kasinatorhh/BTSpidey/Design/images/20200213_211251.jpg

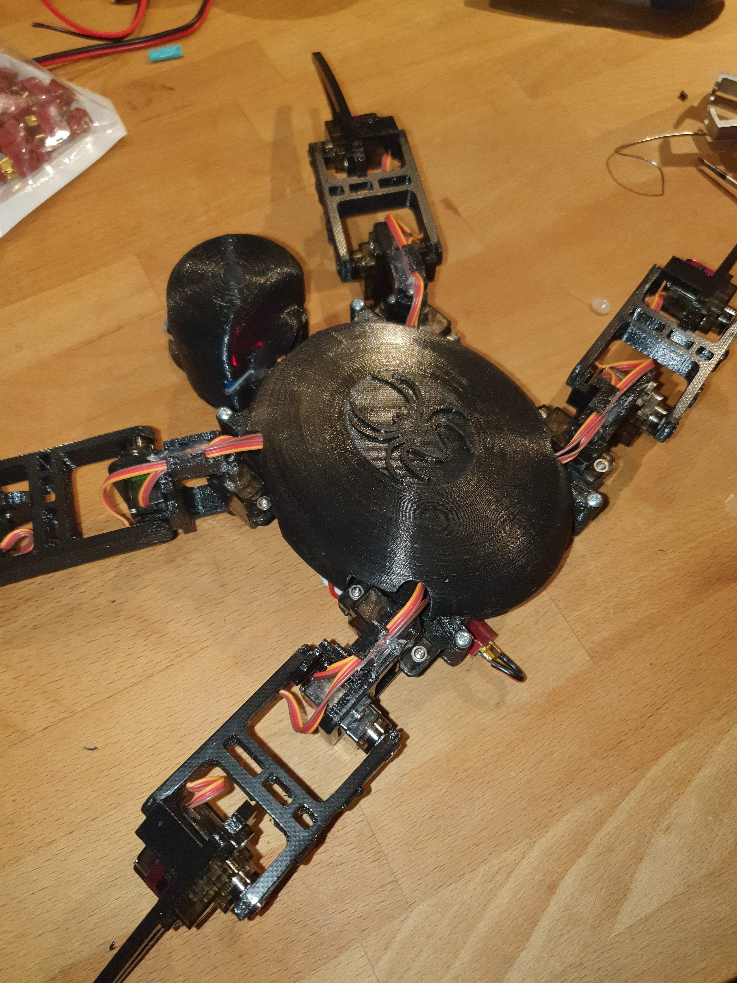
Design/images/20200213_211251.jpg
