kasinatorhh/BTSpidey/Design/images/20200117_162846.jpg

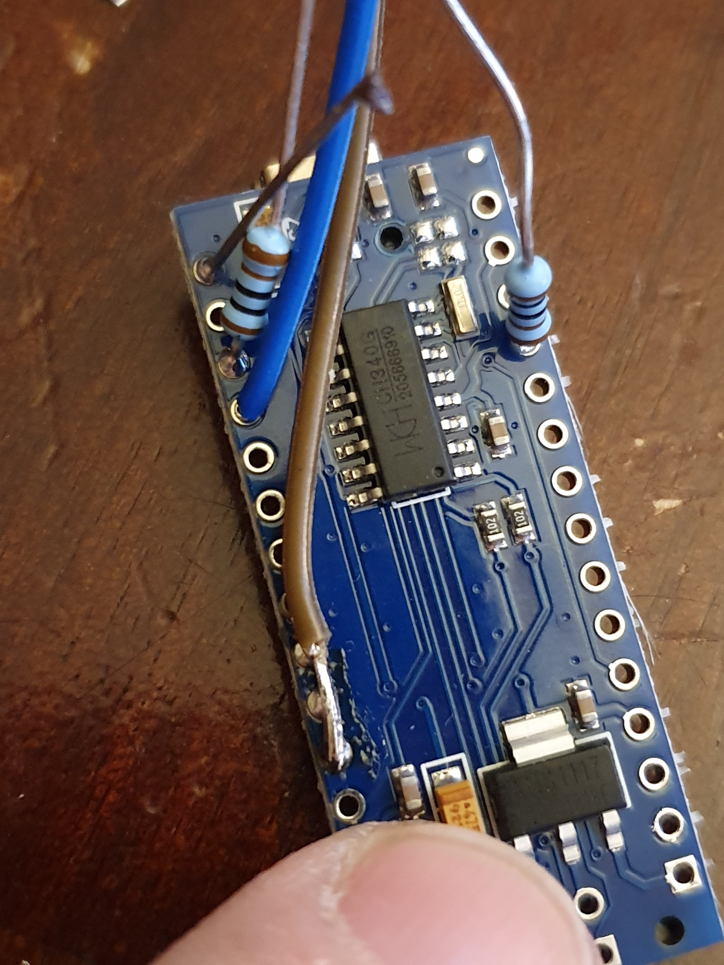
Design/images/20200117_162846.jpg
