kasinatorhh/BTSpidey/Design/README.txt

Spider Bug Robot(quad robot, quadruped)-MG90 by kasinatorhh on Thingiverse: https://www.thingiverse.com/thing:4070234
