kasinatorhh/BTSpidey/Design/images/20191230_092558.jpg

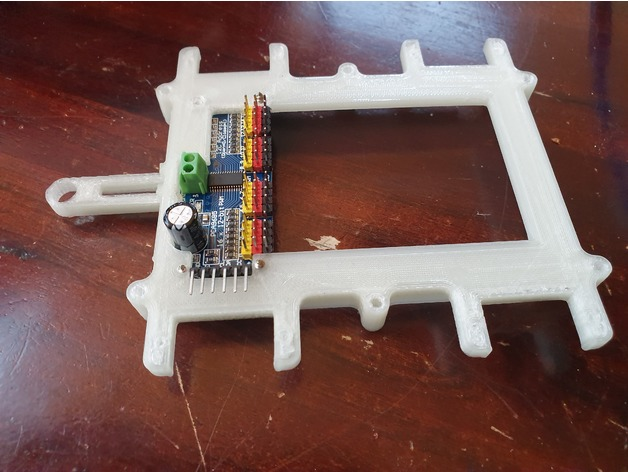
Design/images/20191230_092558.jpg
