kasinatorhh/BTSpidey/Design/images/20200117_161942.jpg

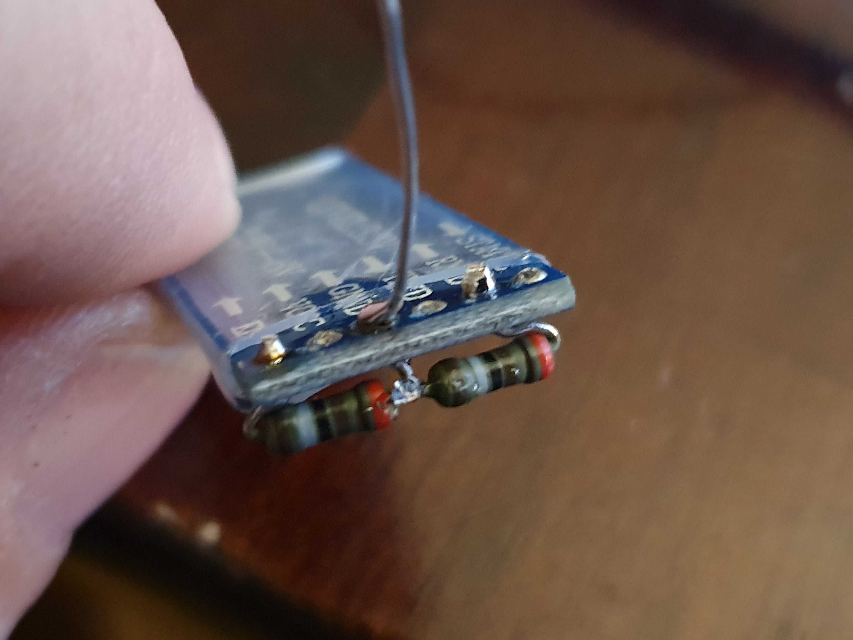
Design/images/20200117_161942.jpg
