kasinatorhh/BTSpidey/Design/images/20200117_161948.jpg

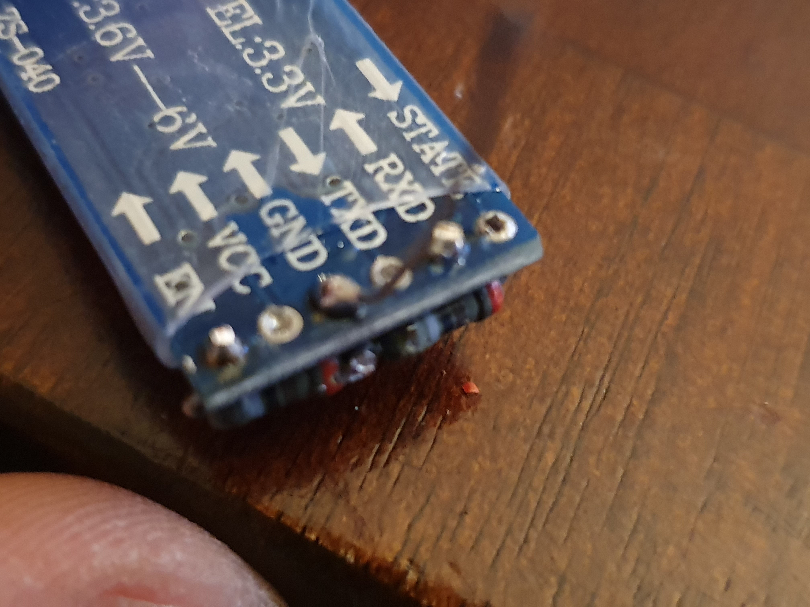
Design/images/20200117_161948.jpg
