kasinatorhh/BTSpidey/Design/images/20200118_225902.jpg

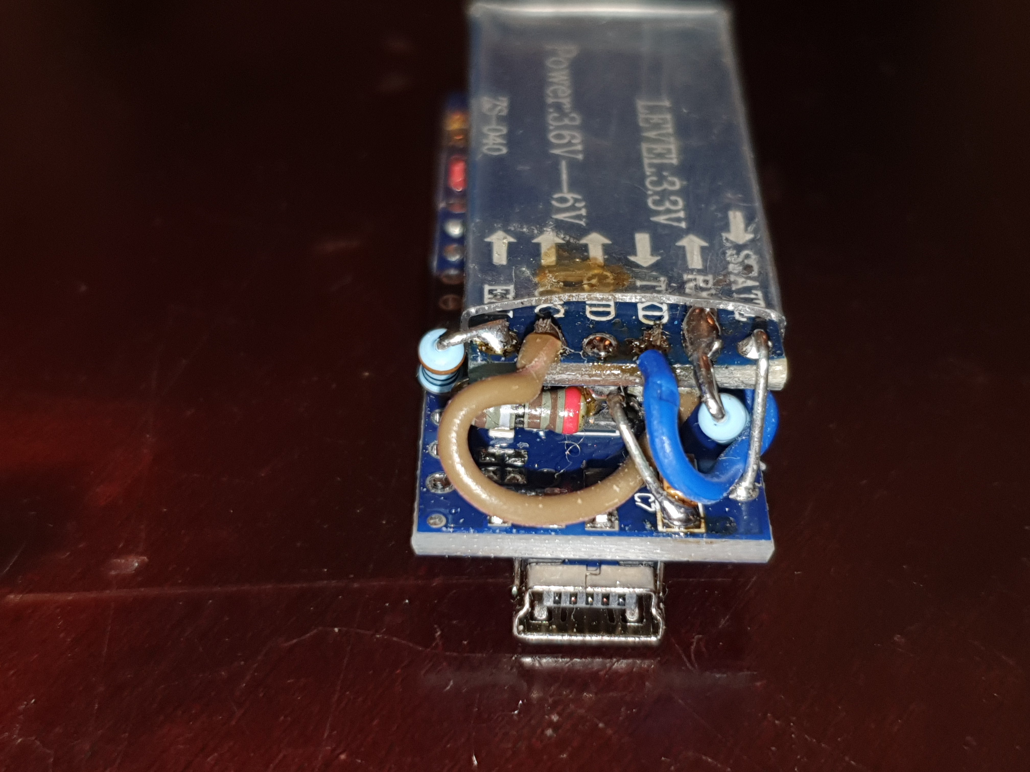
Design/images/20200118_225902.jpg
