kasinatorhh/BTSpidey/Design/images/20200120_192505.jpg

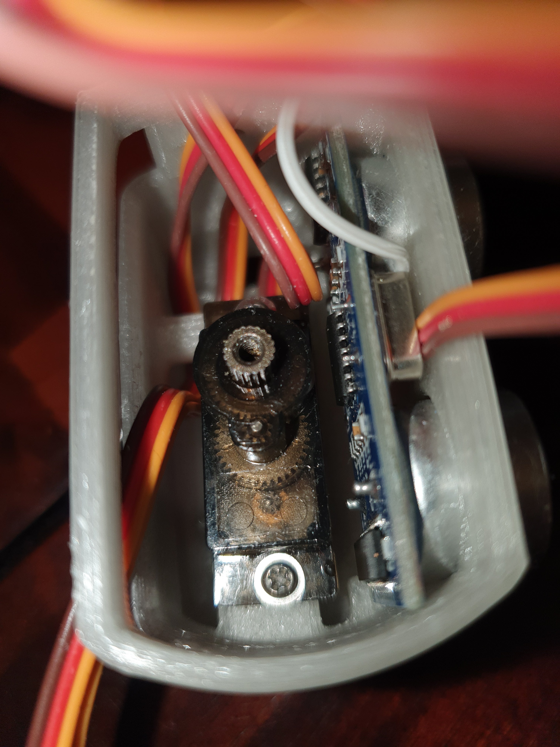
Design/images/20200120_192505.jpg
