kasinatorhh/BTSpidey/Design/images/20200120_193120.jpg

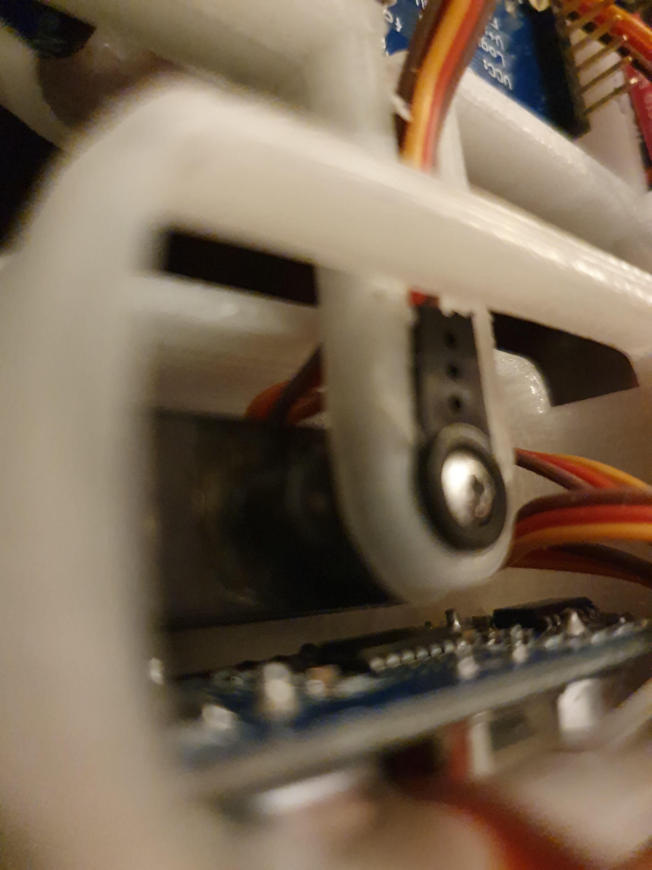
Design/images/20200120_193120.jpg
