kasinatorhh/BTSpidey/Design/images/20200213_205349.jpg

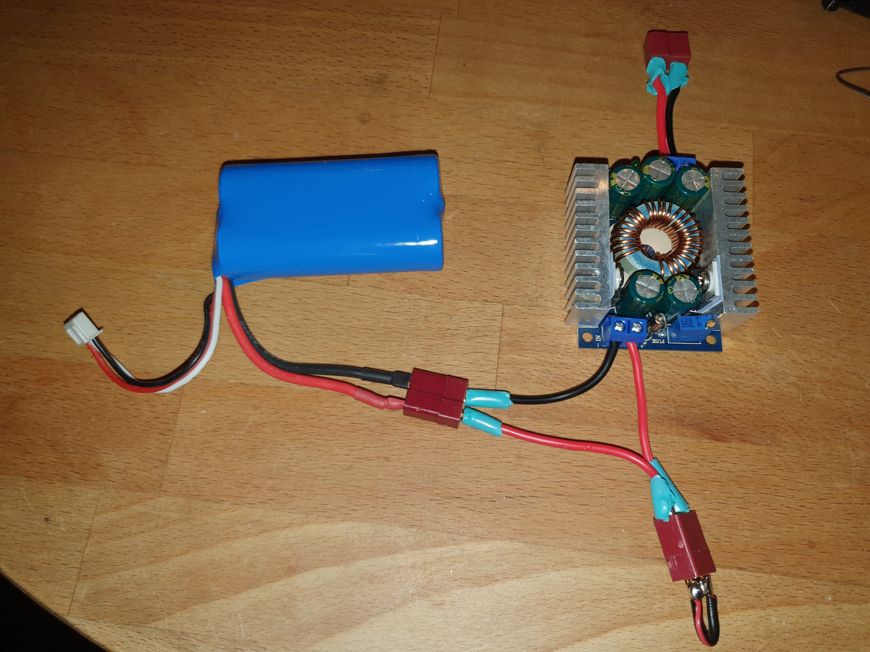
Design/images/20200213_205349.jpg
