kasinatorhh/BTSpidey/Design/images/20200213_210731.jpg

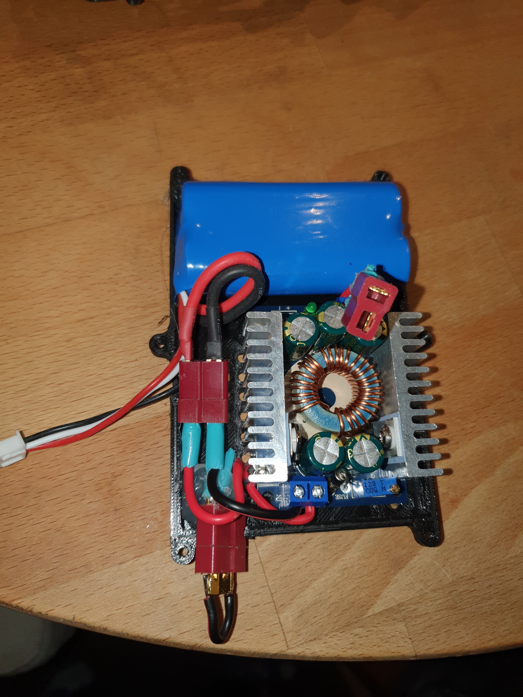
Design/images/20200213_210731.jpg
