kasinatorhh/BTSpidey/Design/images/Allparts_Description.png

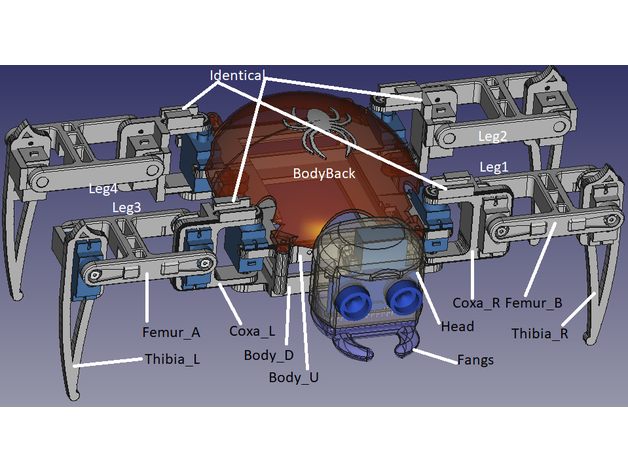
Design/images/Allparts_Description.png
