kasinatorhh/BTSpidey/Design/images/Boddy_Bottom_Lipo.png

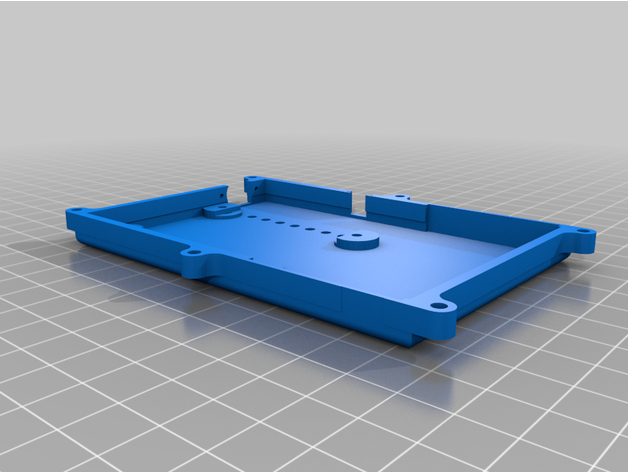
Design/images/Boddy_Bottom_Lipo.png
