kasinatorhh/BTSpidey/Design/images/BodyBack_V4_AdaptiveHeight.png

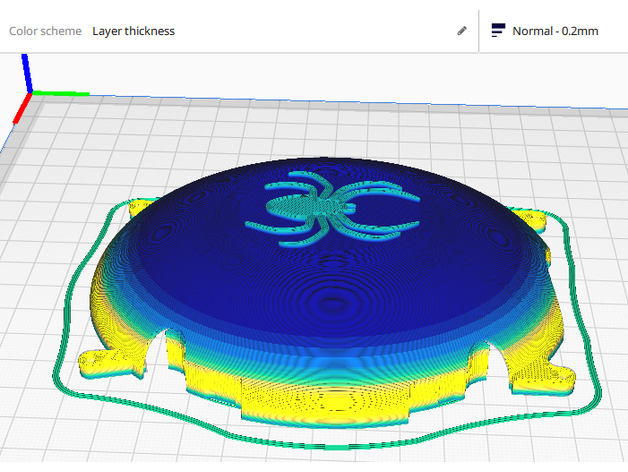
Design/images/BodyBack_V4_AdaptiveHeight.png
