kasinatorhh/BTSpidey/Design/images/BodyBack_V4_higher.png

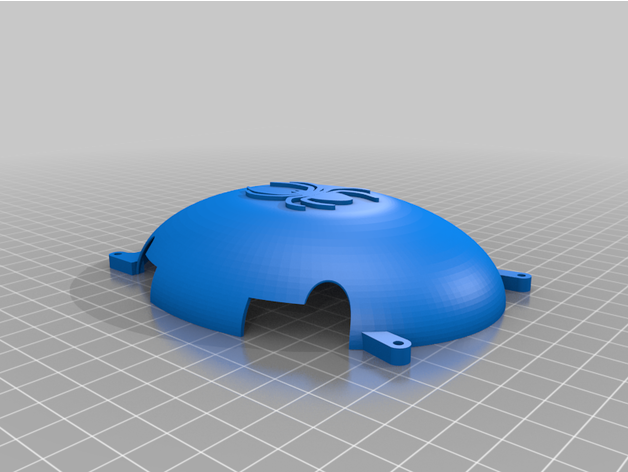
Design/images/BodyBack_V4_higher.png
