kasinatorhh/BTSpidey/Design/images/Femur_MG90_B.png

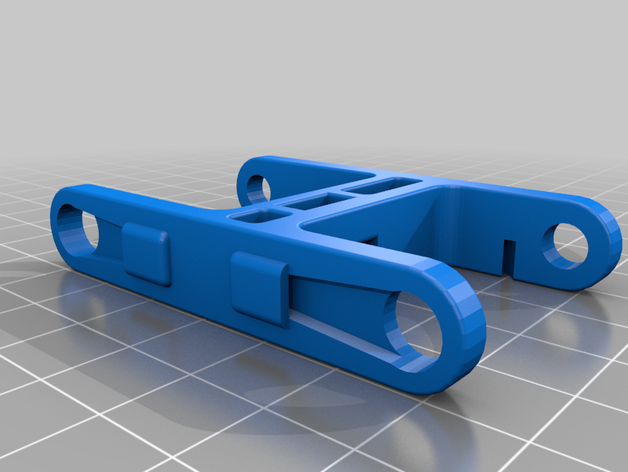
Design/images/Femur_MG90_B.png
