kasinatorhh/BTSpidey/Design/images/Head_Nano.png

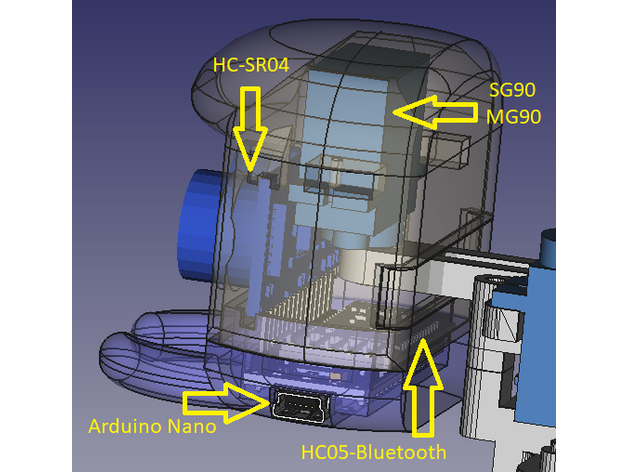
Design/images/Head_Nano.png
