kasinatorhh/BTSpidey/Design/images/ServoAlign.png

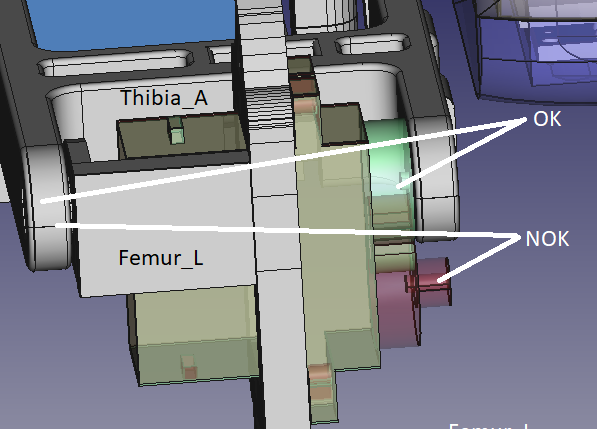
Design/images/ServoAlign.png
