kasinatorhh/BTSpidey/Design/images/SpiderRobot_Steckplatine_B.png

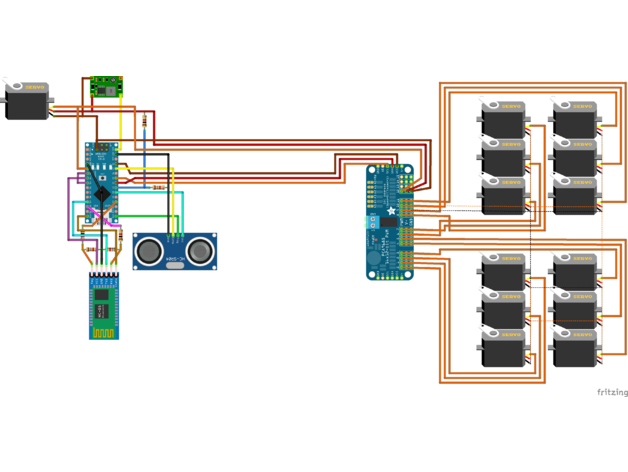
Design/images/SpiderRobot_Steckplatine_B.png
