kasinatorhh/BTSpidey/Design/images/tibia_r_MG90.png

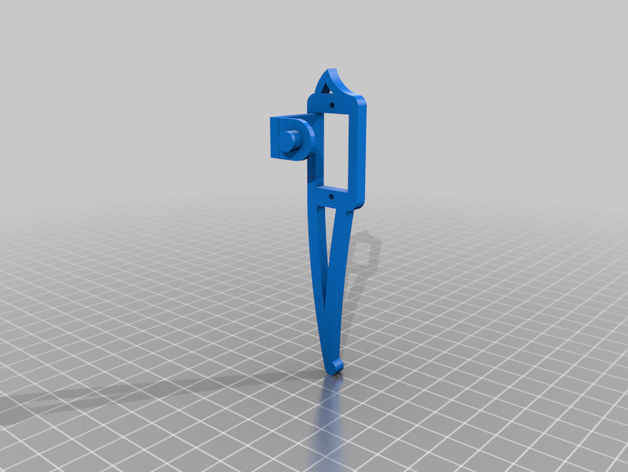
Design/images/tibia_r_MG90.png
