kasinatorhh/BTSpidey/Design/files/BodyBack_V4_higher.stl

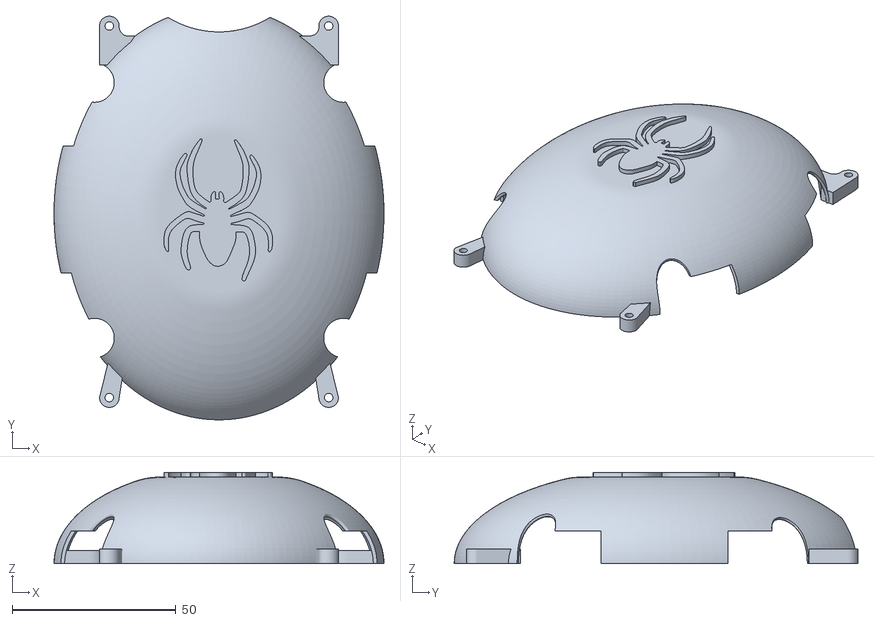
[picture p20: CAD file, 2020-02-22]
Design/files/BodyBack_V4_higher.stl
100.8 x 123.3 x 27.9
