kasinatorhh/BTSpidey/Design/files/Body_u_L_PCA_V2.stl

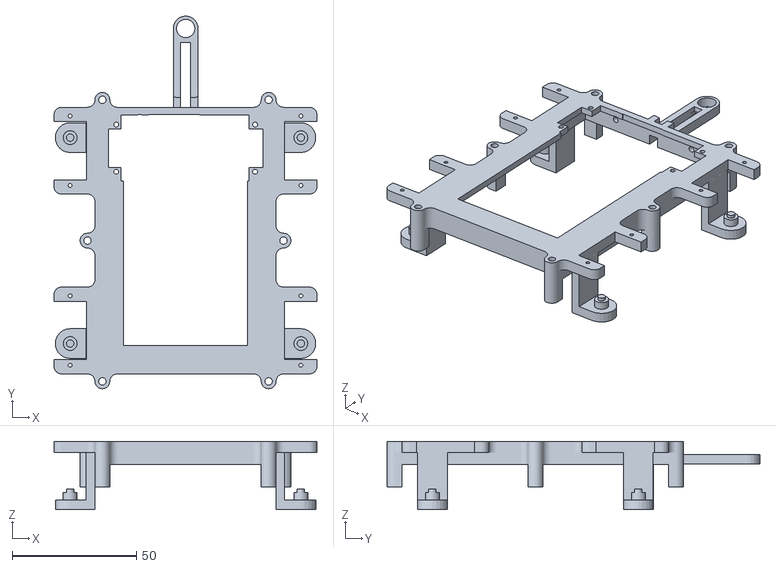
[picture p21: CAD file, 2020-02-22]
Design/files/Body_u_L_PCA_V2.stl
106.0 x 150.2 x 27.6
