kasinatorhh/BTSpidey/Design/files/BodyBack_V2_Spider.stl

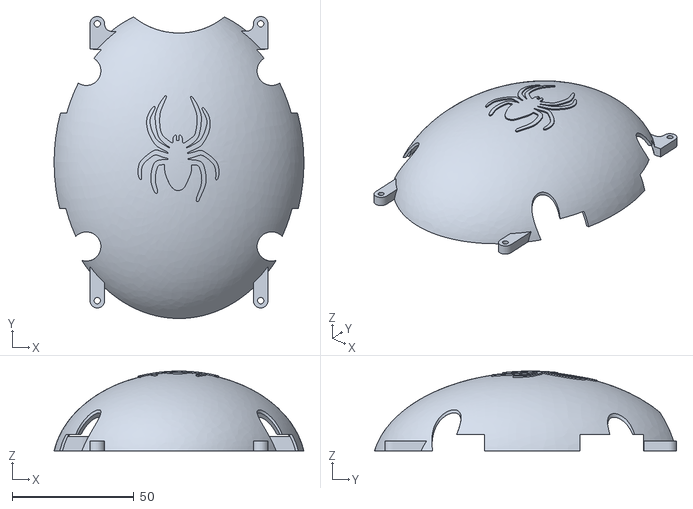
[picture p22: CAD file, 2020-02-22]
Design/files/BodyBack_V2_Spider.stl
102.4 x 123.8 x 32.7
