kasinatorhh/BTSpidey/Design/files/Coxa_L_MG90.stl

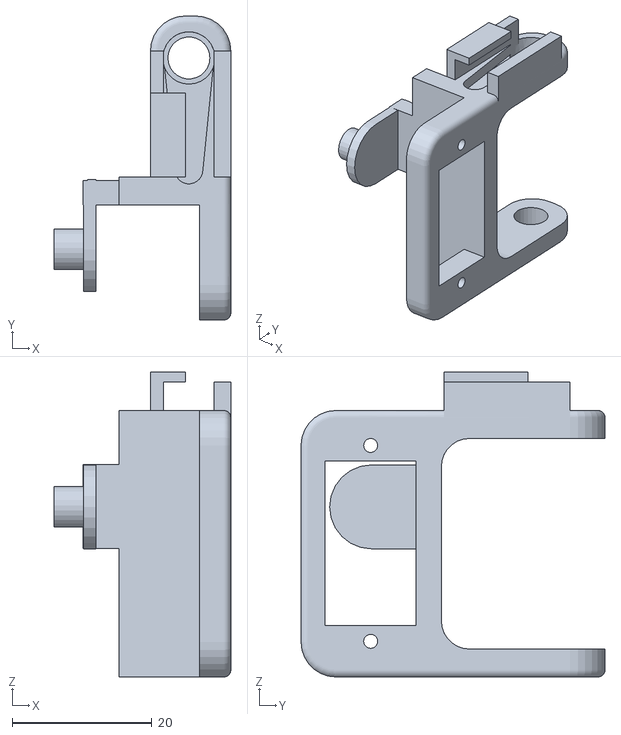
[picture p23: CAD file, 2020-02-22]
Design/files/Coxa_L_MG90.stl
25.3 x 43.5 x 43.6
