kasinatorhh/BTSpidey/Design/files/Fang_Nano2.stl

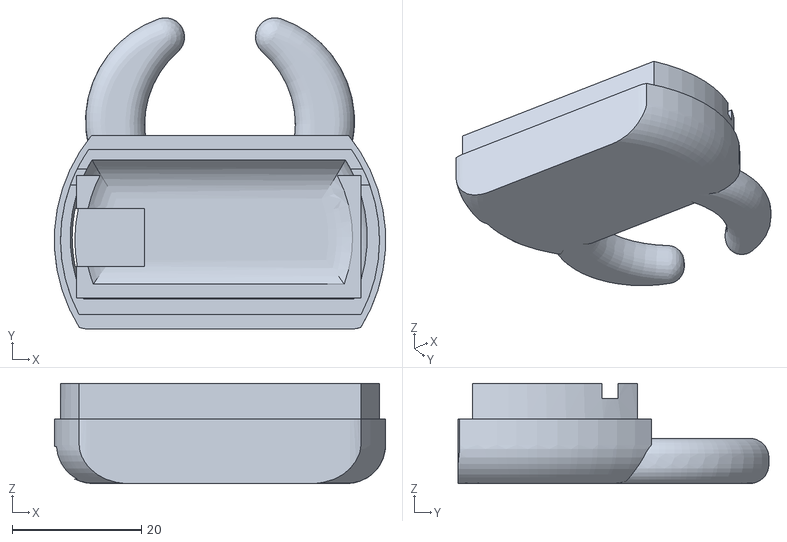
[picture p24: CAD file, 2020-02-22]
Design/files/Fang_Nano2.stl
51.3 x 48.2 x 15.5
