kasinatorhh/BTSpidey/Design/files/tibia_r_MG90.stl

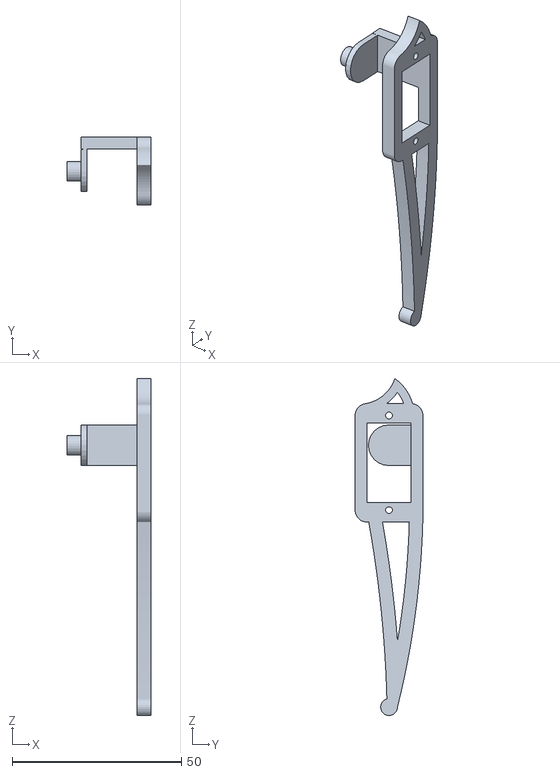
[picture p25: CAD file, 2020-02-22]
Design/files/tibia_r_MG90.stl
24.9 x 20.0 x 99.7
