kasinatorhh/BTSpidey/Design/files/Fangs_Hollow5.stl

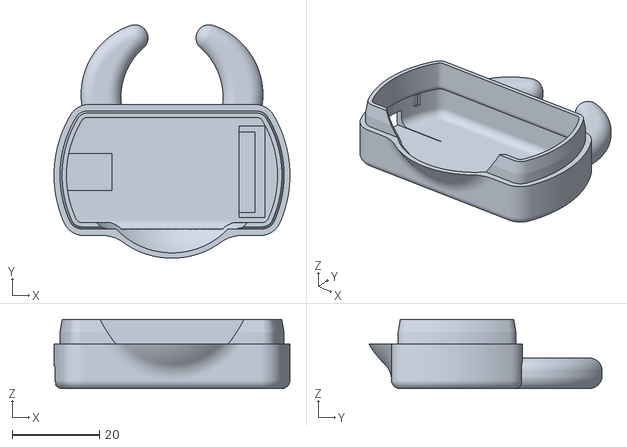
[picture p26: CAD file, 2020-02-22]
Design/files/Fangs_Hollow5.stl
54.0 x 53.4 x 15.8
