kasinatorhh/BTSpidey/Design/files/Head_Hollow3.stl

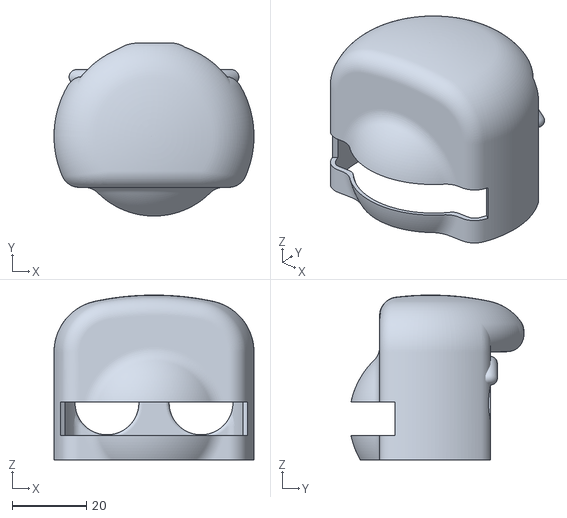
[picture p27: CAD file, 2020-02-22]
Design/files/Head_Hollow3.stl
54.0 x 46.7 x 44.5
