kasinatorhh/BTSpidey/Design/files/Femur_MG90_A.stl

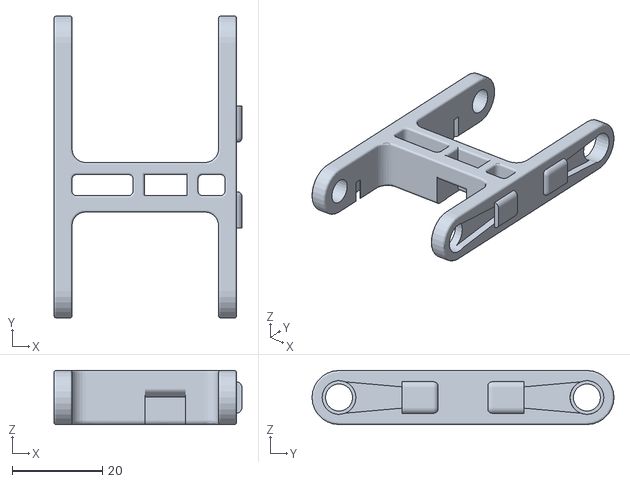
[picture p28: CAD file, 2020-02-22]
Design/files/Femur_MG90_A.stl
41.7 x 67.0 x 12.0
