kasinatorhh/BTSpidey/Design/files/Head_Nano.stl

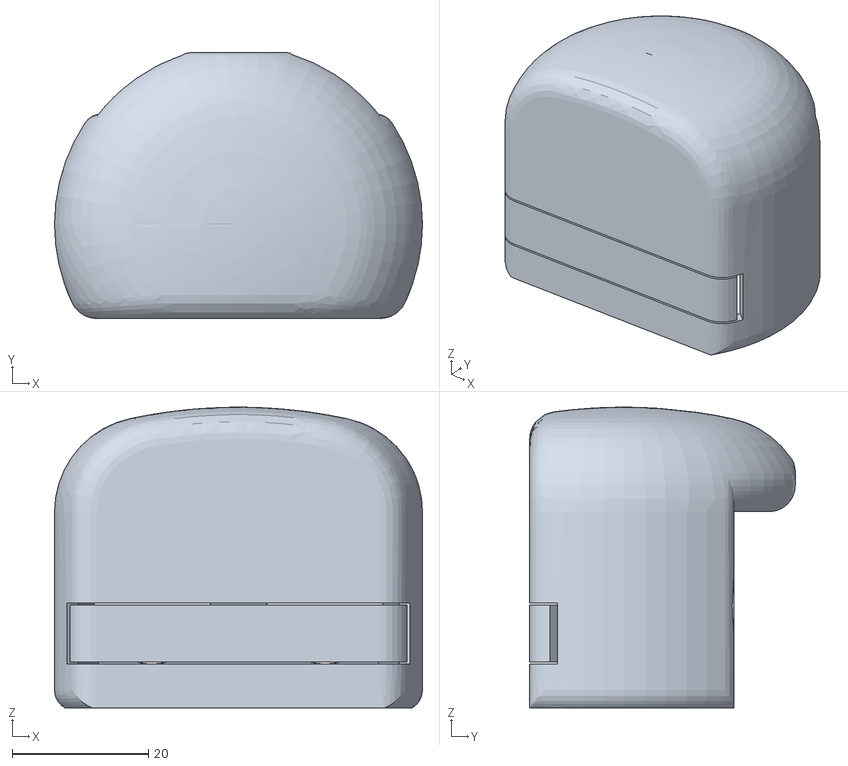
[picture p29: CAD file, 2020-02-22]
Design/files/Head_Nano.stl
54.0 x 39.0 x 44.1
