kasinatorhh/BTSpidey/Design/files/body_u_L_PCA_Neck.stl

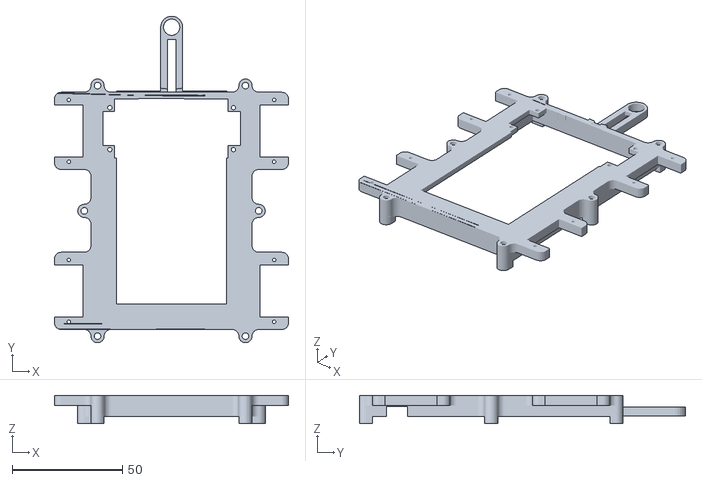
[picture p30: CAD file, 2020-02-22]
Design/files/body_u_L_PCA_Neck.stl
106.0 x 147.9 x 12.7
