kasinatorhh/BTSpidey/Design/files/Body_d_L_Cap_V2.stl

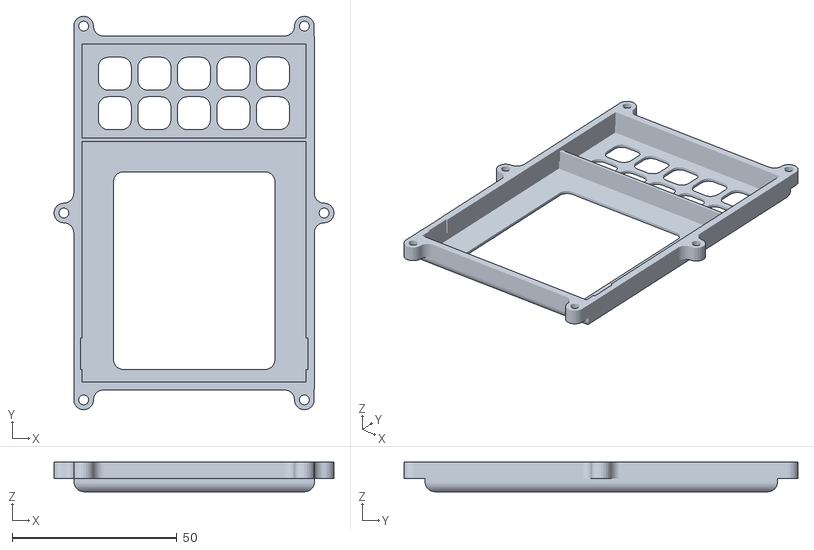
[picture p31: CAD file, 2020-02-22]
Design/files/Body_d_L_Cap_V2.stl
85.0 x 119.5 x 9.00
