kasinatorhh/BTSpidey/Design/files/BodyBack_V2.stl

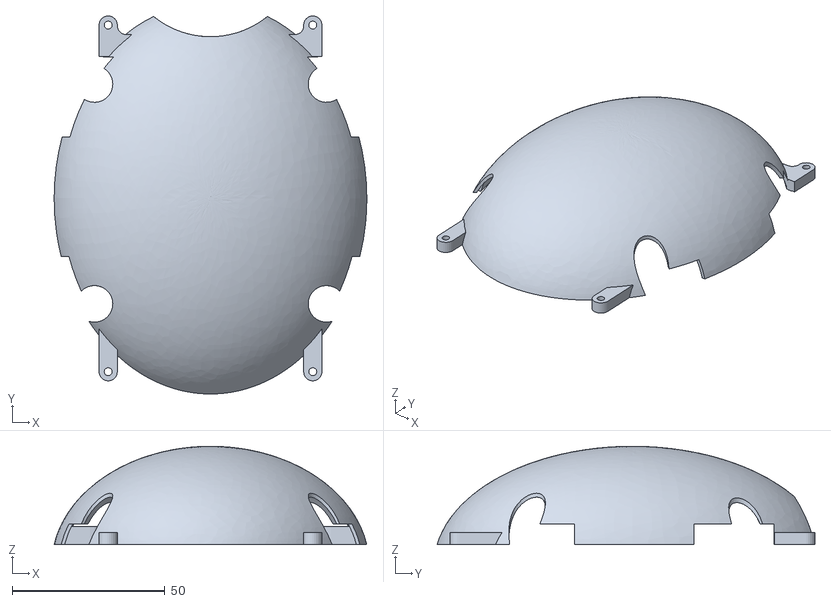
[picture p32: CAD file, 2020-02-22]
Design/files/BodyBack_V2.stl
102.4 x 123.8 x 32.2
