kasinatorhh/BTSpidey/Design/files/Boddy_Bottom_Lipo.stl

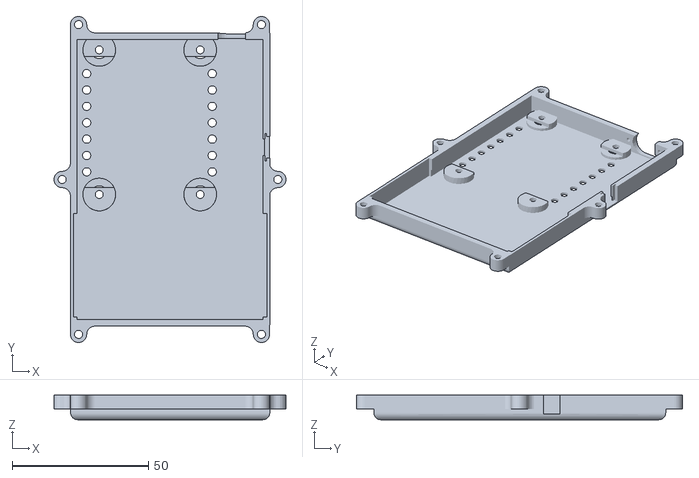
[picture p33: CAD file, 2020-02-22]
Design/files/Boddy_Bottom_Lipo.stl
85.0 x 119.5 x 9.00
