kasinatorhh/BTSpidey/Design/files/Neck_V2.stl

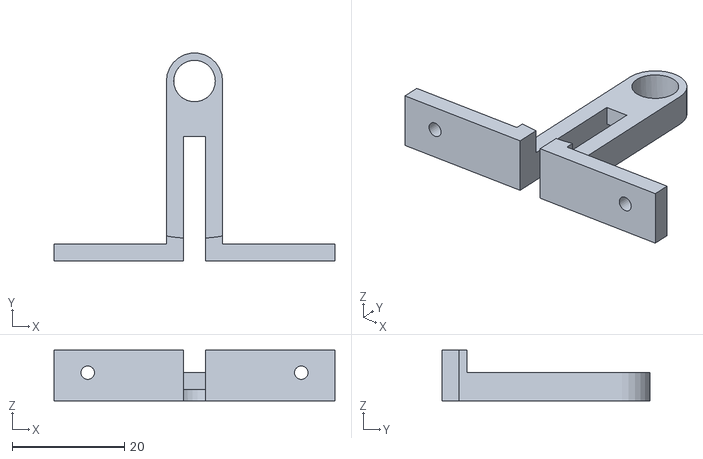
[picture p34: CAD file, 2020-02-22]
Design/files/Neck_V2.stl
50.0 x 37.0 x 9.00
