kasinatorhh/BTSpidey/(list of files, cad)

Other CAD files:
Design/files/Cora_r_MG90.stl
Design/files/Femur_MG90_B.stl
Design/files/tibia_l_MG90.stl
Design/files/body_d_L_Screws.stl
