kasinatorhh/BTSpidey/(commit log)

2020-02-07 Initial Commit. Still lot of things to do: -Communication Stability (single-Bit-Errors on SoftwareUart-Receive) -Change Cartesian_to_Polar calculation to Integer to speed up -Somehow the HeadUp/Down 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
    [BTSpidey.ino, MoveCore.cpp, MoveCore.h, ServoHAL.cpp, ServoHAL.h, Spider_Hardware.h, TwoSerialWrap.cpp, TwoSerialWrap.h]
2020-02-15 Repaired: -EEPROM Lock handling -Lockup when Moving without ServoTimer active Added: Added Speed-Adjuster: W 1 <Speed> in % (integer divided by 100. Can be >100) Fixed missing Command handlers in Mov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
    [BTSpidey.ino, MoveCore.cpp, MoveCore.h, ServoHAL.cpp, Spider_Hardware.h]
2020-03-03 Reworked Reception mode to allow REDUCED function set, when using BTRemote. Added BTRemote-Mode redundant data checks (makes resiliant against Bit-Errors)
    Added Polar-Control Mode, allows to make moves where Cartesian control would eat up your brain or flips over impossible positions.
    Added "Park Position +", that moves Spidey to a minimum Volume occupancy.
    + is sent by HC05 Bluetooth module, when Bluetooth gets disconnected.
    [BTSpidey.ino, MoveCore.cpp, MoveCore.h, Spider_Hardware.h]
